NTU-UpStream/LASS-WaterBox-V2-Pro/PCB Design/LASS_WaterBox_LinkIt7697_v2.1pro/SolderpasteTop.png

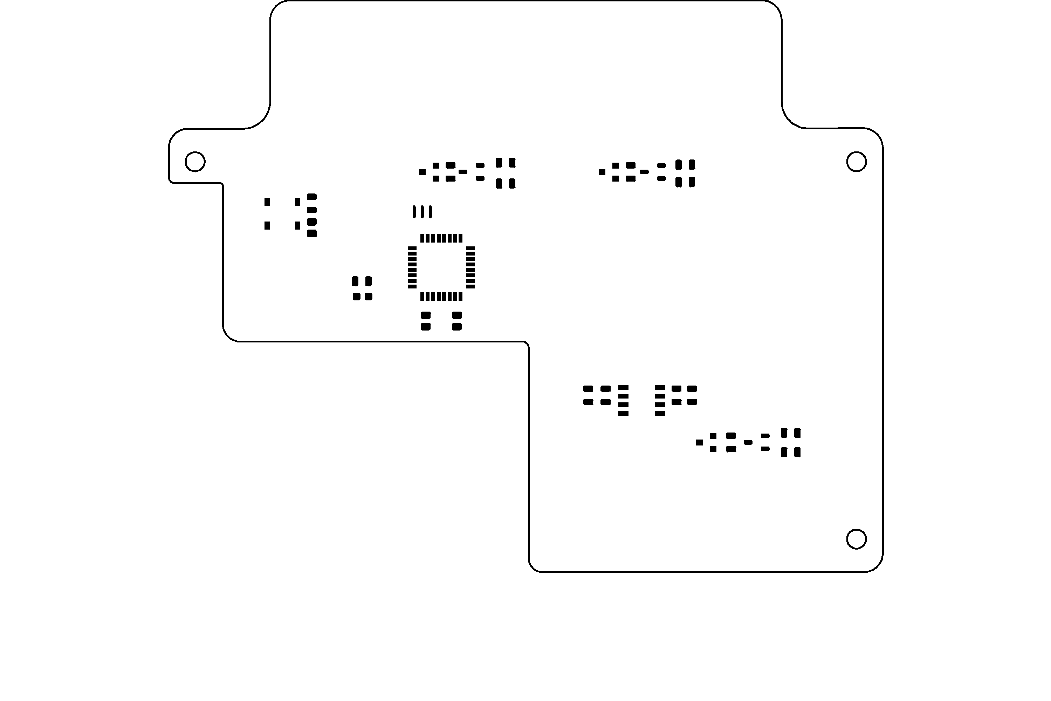
PCB Design/LASS_WaterBox_LinkIt7697_v2.1pro/SolderpasteTop.png
