NTU-UpStream/LASS-WaterBox-V2-Pro/UK NBIOT Test/修改成登入CAT-M1.png

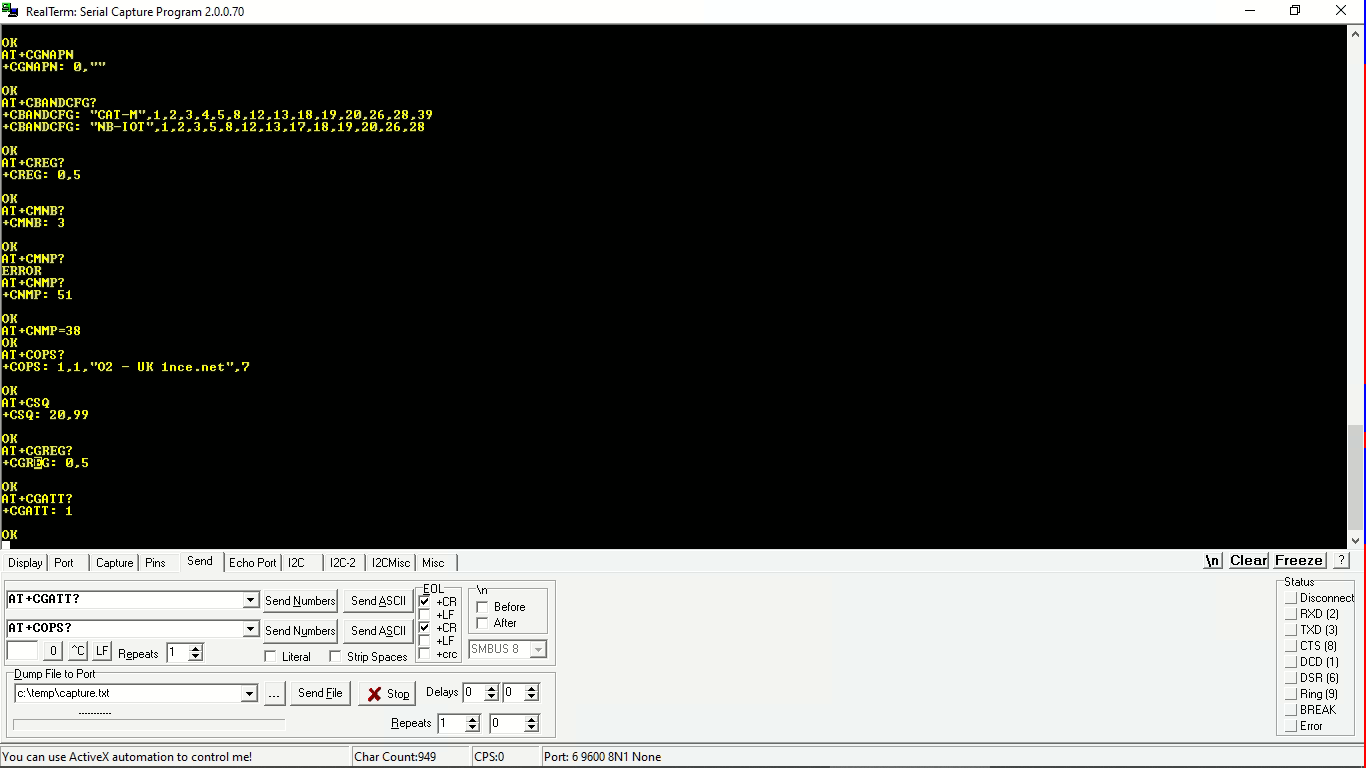
UK NBIOT Test/修改成登入CAT-M1.png
