NTU-UpStream/LASS-WaterBox-V2-Pro/UK NBIOT Test/重開機後測試設定-2.jpg

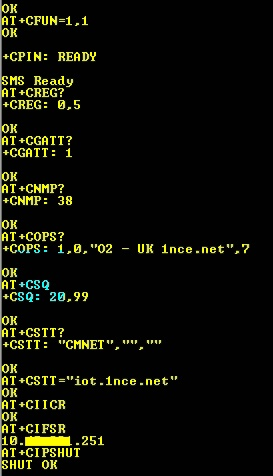
UK NBIOT Test/重開機後測試設定-2.jpg
