NTU-UpStream/LASS-WaterBox-V2-Pro/PCB Design/LASS_WaterBox_LinkIt7697_v2.1pro/base.brd

## EAGLE design PCB Design/LASS_WaterBox_LinkIt7697_v2.1pro/base.brd (2022-01-22)

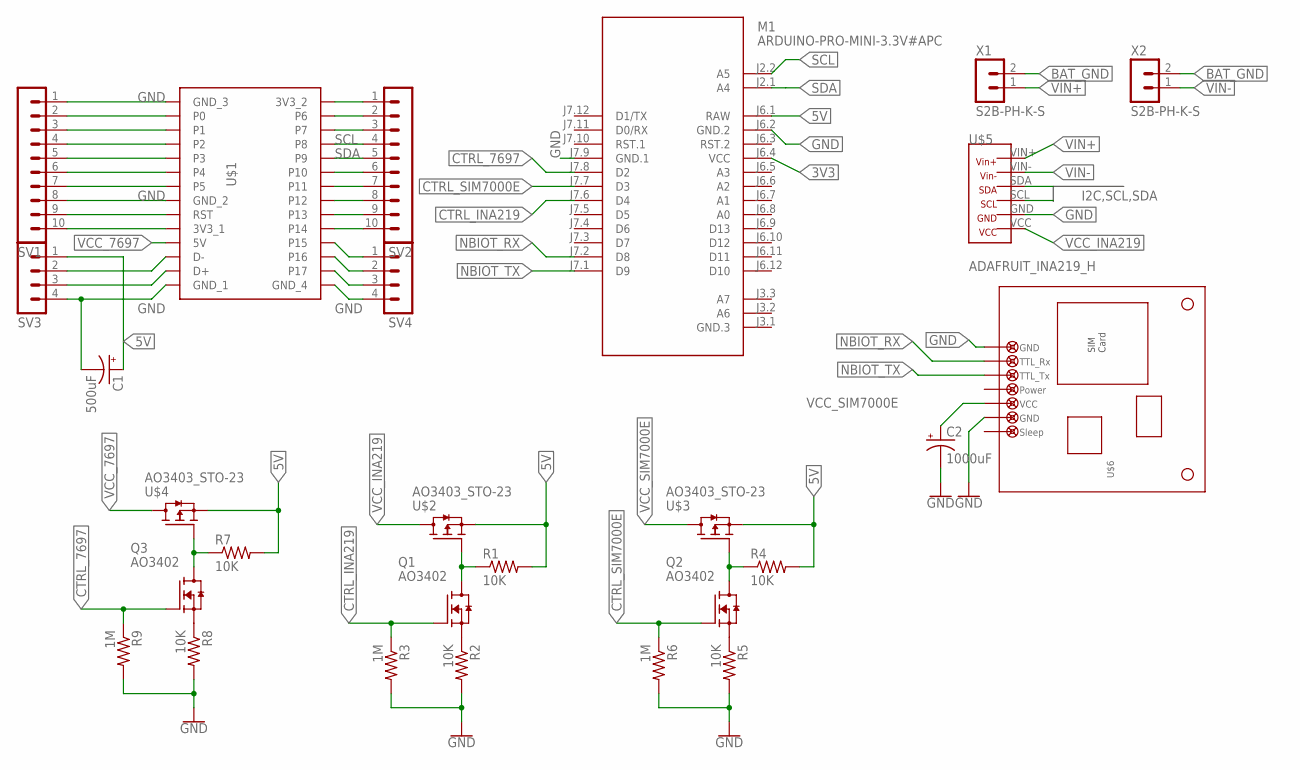
[picture p4: schematic base.sch]

Parts:
C1: 500uF; TT2D5
C2: 1000uF; TT2D5L
M1: ARDUINO-PRO-MINI-3.3V#APC; ARDUINO-PRO-MINI#APC
Q1, Q2, Q3: AO3402; SOT95P280X125-3N
R1, R2, R4, R5, R7, R8: 10K; 0207/10
R3, R6, R9: 1M; 0207/10
SV1, SV2: MA10-1
SV3, SV4: MA04-1
U$1: LINKIT_7697
U$2, U$3, U$4: AO3403_STO-23; SOT23
U$5: ADAFRUIT_INA219_H
U$6: SIM7000E; SIM7000E_AND-GLOBAL
X1, X2: S2B-PH-K-S

Connections:
3V3: M1.J6.4 (VCC)
5V: C1.+, M1.J6.1 (RAW), R1.2, R4.2, R7.2, SV3.1, U$2.2 (S), U$3.2 (S), U$4.2 (S)
BAT_GND: X1.2, X2.2
CTRL_7697: M1.J7.8 (D2), Q3.1 (G), R9.1
CTRL_INA219: M1.J7.6 (D4), Q1.1 (G), R3.1
CTRL_SIM7000E: M1.J7.7 (D3), Q2.1 (G), R6.1
GND: C1.-, C2.-, M1.J6.2 (GND.2), M1.J7.9 (GND.1), R2.2, R3.2, R5.2, R6.2, R8.2, R9.2, SV1.1, SV1.8, SV3.4, SV4.4, U$1.GND_1, U$1.GND_2, U$1.GND_3, U$1.GND_4, U$5.GND, U$6.S_GND, U$6.V_GND
unnamed: Q1.2 (S), R2.1
unnamed: Q1.3 (D), R1.1, U$2.1 (G)
unnamed: Q2.2 (S), R5.1
unnamed: Q2.3 (D), R4.1, U$3.1 (G)
unnamed: Q3.2 (S), R8.1
unnamed: Q3.3 (D), R7.1, U$4.1 (G)
unnamed: SV1.2, U$1.P0
unnamed: SV1.3, U$1.P1
unnamed: SV1.4, U$1.P2
unnamed: SV1.5, U$1.P3
unnamed: SV1.6, U$1.P4
unnamed: SV1.7, U$1.P5
unnamed: SV1.9, U$1.RST
unnamed: SV1.10, U$1.3V3_1
unnamed: SV3.2, U$1.D-
unnamed: SV3.3, U$1.D+
unnamed: SV4.3, U$1.P17
unnamed: SV4.2, U$1.P16
unnamed: SV4.1, U$1.P15
unnamed: SV2.10, U$1.P14
unnamed: SV2.9, U$1.P13
unnamed: SV2.8, U$1.P12
unnamed: SV2.7, U$1.P11
unnamed: SV2.6, U$1.P10
unnamed: SV2.3, U$1.P7
unnamed: SV2.2, U$1.P6
unnamed: SV2.1, U$1.3V3_2
NBIOT_RX: M1.J7.2 (D8), U$6.RX
NBIOT_TX: M1.J7.1 (D9), U$6.TX
SCL: M1.J2.2 (A5), SV2.4, U$1.P8, U$5.SCL
SDA: M1.J2.1 (A4), SV2.5, U$1.P9, U$5.SDA
VCC_7697: U$1.5V, U$4.3 (D)
VCC_INA219: U$2.3 (D), U$5.VCC
VCC_SIM7000E: C2.+, U$3.3 (D), U$6.VCC
VIN+: U$5.VIN+, X1.1
VIN-: U$5.VIN-, X2.1

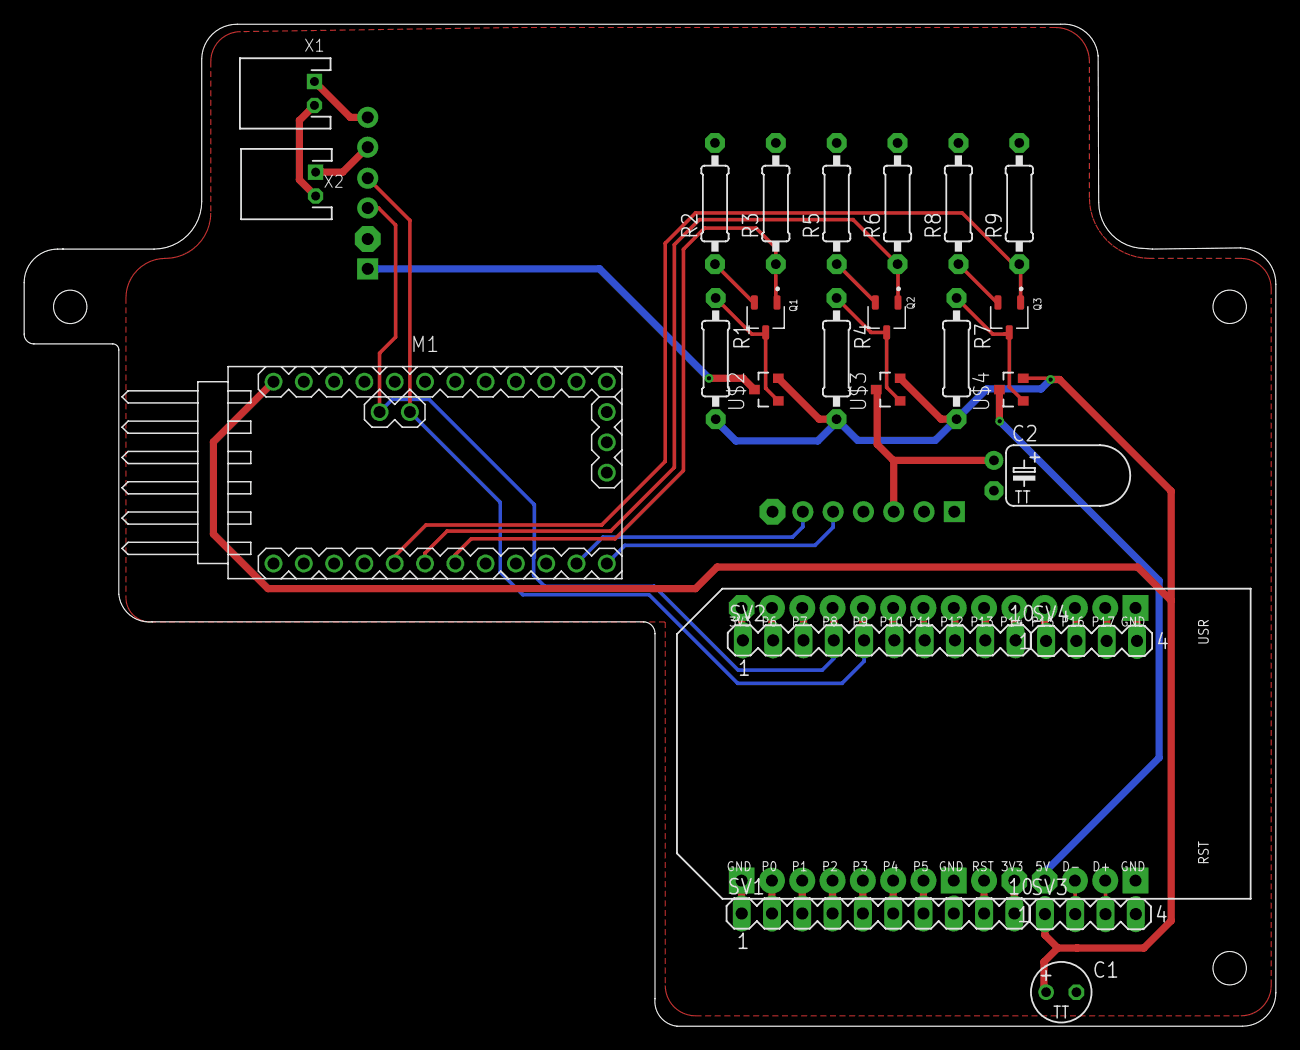
[picture p5: board base.brd from above]

Board: 2 copper layers, 104.9 x 84.0 mm, 27 parts (1 on the bottom side), 42 nets.
