NTU-UpStream/LASS-WaterBox-V2-Pro/Firmware/AllSystem_PMU_V2.1/AllSystem_PMU_V2.1.ino

/*
  Name:    WaterBox_2.ino
  Created: 2020/3/10 下午 07:28:01
  Author:  Liu
*/
#include <Adafruit_INA219.h> // 1.0.6
#include "WaterBox_PMU.h"
WaterBox_PMU PMU;

#include "SIM7000.h"
#define SIMCOM 3
SIM7000 NBIOT;


// LASS MQTT Config
#define Server_LASS "gpssensor.ddns.net"
#define Port_LASS   1883
#define MQTT_LASS_Topic "LASS/Test/WaterBox_TW/"

#define MSG_Init "|device=Linkit7697|ver_app=1.1.0|tick=0|FAKE_GPS=1"

// String _Data;
// String AT_Buffer;

// String id_str, topic_str, msg_str;
// String _buffer_str;


char STR_BUFFER[20];

char MQTT_TOPIC[35]={'\0'};  // LASS/Test/WaterBox_TW/8c882b00d4c6
char MQTT_ID[18]={'\0'};
char MQTT_MSG[300] = {'\0'};

byte MQTT_CONNECT[64] = {0};

uint32_t MQTT_PL = 0;
byte MQTT_RL[4];
uint16_t BUFFER_SIZE;
String radom_str;


/***********<< 封包格式 >>**********
  CONNECT
  PUBLISH
*********************************/
struct PUBLISH {
  uint8_t Fix_Header = 0x30 | 0b0010; // 0x30(publish) | 0b0010 (QoS:1)| 0b0001 (Retain)
  byte RL[4];
  uint8_t RL_size;

  byte PL_topic[2];
  byte TOPIC[40];

  byte PL_msg[2];
  byte MSG[300];
};

struct CONNECT {
  uint8_t Fix_Header = 0x10;
  byte RL[4];
  uint8_t RL_size;
  byte Flags = 0x02;                                     // Connect flags: 0b00000010 (Clean Session)
  byte Protocol[7] = {
    0x00, 0x04,                                          // Protocol Length: 4
    (byte)'M', (byte)'Q',  (byte)'T',  (byte)'T',        // Protocol Name:MQTT
    0x04                                                 // Protocol level (mqtt3.1.1 是0x04)
  };
  byte KeepAlive[2] = {0x00, 0x3C};                       // Keep Alive: 60 sec

  byte PL_id[2];
  byte ID[16];
};

CONNECT CONNECT_KPG;
PUBLISH PUBLISH_KPG;


/***********<< 資料整理 >>**********
  ZeroPadding
*********************************/
String ZeroPadding(byte _value) {
  if (_value < 16)  return "0" + String(_value, HEX);
  else              return String(_value, HEX);
}

void showByteBuffer(byte* _buffer, uint16_t _size) {
  for (uint16_t _i = 0; _i < _size; _i++) {
    //    Serial.print(F("0x"));
    //    Serial.print(ZeroPadding(_buffer[_i]));
    //    Serial.print(F(" "));
    Serial.print((char)_buffer[_i]);
    if (_i % 10 == 9) Serial.print(F("\r\n"));
    delay(10);
  }
  Serial.println(F("\r\n"));
}

/***********<< 封包格式 >>**********
  CalculateRL 計算RL, 填入MQTT_RL Buffer內，回傳用掉幾個bytes
*********************************/
uint8_t CalculateRL(uint32_t _size) {
  uint8_t _index = 0;
  do
  {
    uint8_t _d = _size % 128;    // 取餘數 _size & 0b01111111
    _size /= 128;                // 取除以128後的整數：_size = _size >> 7;
    if (_size > 0)  _d |= 0x80;  // 除128的整數 > 0 時，對_d + 128 (bit[7]為1)
    MQTT_RL[_index] = _d;        // 計算好的 _d 放到 buffer內
    if (_index < 3)    _index++; // 避免寫入buffer爆掉，限制_index不超過3
  } while (_size > 0);
  return _index;
}




void setup()
{
  Serial.begin(9600);

  NBIOT.begin(9600);
  NBIOT.setDebuger(Serial);
  NBIOT.init(SIMCOM);

  PMU.init();
  //  PMU.setDebuger(Serial);
  PMU.setSleepSec(2);
  PMU.setWakeUpVolate(3.2);
  PMU.PowerSaveMode(PMU.ON); // PMU.ON進入睡眠, Delay不睡覺 PMU.OFF
  PMU.setINA219(0x40);

  Serial.println(F("[System] Setup Done"));
  // 先睡一次，讓MCU 取得資料並且紀錄
  PMU.Sleep();

  radom_str = (String)"_" + (char)random(65, 90) + (char)random(65, 90) + (char)random(97, 122) + (char)random(97, 122);

}

void loop()
{
  if (PMU.state == PMU.MASTER)
  {
    //    showConfig();

    // 建立Topic
    memset(MQTT_TOPIC, '\0', 35); // 清空 Topic Buffer
    strcat(MQTT_TOPIC, MQTT_LASS_Topic);
    PMU.Field_3.toCharArray(STR_BUFFER,PMU.Field_3.length() + 1);
    strcat(MQTT_TOPIC, STR_BUFFER);

    // 建立 從Field 建立ID 的String
    id_str = PMU.Field_3 + radom_str;

    memset(MQTT_ID, '\0', 18); // 清空 ID Buffer
    strcat(MQTT_ID, STR_BUFFER);
    radom_str.toCharArray(STR_BUFFER,radom_str.length() + 1);
    strcat(MQTT_ID, STR_BUFFER);

    
    // id_str.toCharArray(CONNECT_KPG.ID, id_str.length() + 1);       // 把 ID 轉為char array

    // topic_str = MQTT_LASS_Topic + PMU.Field_3;
    // topic_str.toCharArray(PUBLISH_KPG.TOPIC, topic_str.length() + 1); // 把 TOPIC 轉為char array
    // PUBLISH_KPG.PL_topic[0] = topic_str.length() / 256;
    // PUBLISH_KPG.PL_topic[1] = topic_str.length() % 256;

    // 把要傳送封包(LASS 格式), 打包成String
    // msg_str = "|device=Linkit7697|device_id=9C65F920C020|ver_app=1.1.0|date=2019-03-21|time=06:53:55|tick=0|FAKE_GPS=1|gps_lon=121.787|gps_lat=25.1933|s_ec=200000.00|s_ph=14.00|s_t0=100.00|s_Tb=10000.00|bat_v=3.70|bat_a=400.00|";
    msg_str = "|device=Linkit7697|ver_app=1.1.0|tick=0|FAKE_GPS=1";
    msg_str.concat(F("|date="));      msg_str.concat(PMU.Field_1);
    msg_str.concat(F("|time="));      msg_str.concat(PMU.Field_2);
    msg_str.concat(F("|device_id=")); msg_str.concat(PMU.Field_3);
    msg_str.concat(F("|gps_lon="));   msg_str.concat(PMU.Field_4);
    msg_str.concat(F("|gps_lat="));   msg_str.concat(PMU.Field_5);
    msg_str.concat(F("|s_ec="));      msg_str.concat(PMU.Field_6);
    msg_str.concat(F("|s_ph="));      msg_str.concat(PMU.Field_7);
    msg_str.concat(F("|s_t0="));      msg_str.concat(PMU.Field_8);
    msg_str.concat(F("|s_Tb="));      msg_str.concat(PMU.Field_9);
    msg_str.concat(F("|bat_v="));     msg_str.concat(PMU.Field_10);
    msg_str.concat(F("|bat_a="));     msg_str.concat(PMU.Field_11);
    msg_str.concat(F("|"));

    Serial.println("[Device ID-1]");
    Serial.println(MQTT_ID);

    Serial.println("[TOPIC-2]");
    Serial.println(MQTT_TOPIC);

    Serial.println("[MQTT MSG]");    
    Serial.println(msg_str);


    CONNECT_KPG.PL_id[0] = msg_str.length() / 256;
    CONNECT_KPG.PL_id[1] = msg_str.length() % 256;

    MQTT_PL = 2 + id_str.length();                      // 計算RL長度 = 2+PL(Topic)+2+PL(Payload)
    CONNECT_KPG.RL_size =  CalculateRL(MQTT_PL);        // 計算RL 用掉幾個bytes，並更新MQTT_RL 這個Buffer
    memcpy(CONNECT_KPG.RL, MQTT_RL, 4);                 // 把MQTT_RL 這個Buffer 複製到PUBLIC_KPG裡面

    // 把LASS封包(String) 塞到Char Buffer當中
    msg_str.toCharArray(PUBLISH_KPG.MSG, msg_str.length() + 1);       // 把 MSG 轉為char array
    PUBLISH_KPG.PL_msg[0] = msg_str.length() / 256;
    PUBLISH_KPG.PL_msg[1] = msg_str.length() % 256;

    MQTT_PL = 2 + topic_str.length() + 2 + msg_str.length();  // 計算RL長度 = 2+PL(Topic)+2+PL(Payload)
    PUBLISH_KPG.RL_size =  CalculateRL(MQTT_PL);              // 計算RL 用掉幾個bytes，並更新MQTT_RL 這個Buffer
    memcpy(PUBLISH_KPG.RL, MQTT_RL, 4);                       // 把MQTT_RL 這個Buffver 複製到PUBLIC_KPG裡面

    // 把TOPIC內容show 出來，確認內容是否ＯＫ
    showByteBuffer(PUBLISH_KPG.TOPIC, topic_str.length() + 6);

  /*  
    // 把MSG內容show 出來，確認內容是否ＯＫ
    showByteBuffer(PUBLISH_KPG.MSG, msg_str.length() + 1);

    NBIOT.AT_CMD(F("AT+CIPSENDHEX=1"), true);               // 設定 TCP/IP的傳輸格式為HEX
    delay(500);
    AT_Buffer = (String)"AT+CSTT=\"" + PMU.APN + "\"";
    NBIOT.AT_CMD(AT_Buffer, true);                         // 設定 APN
    delay(1500);
    NBIOT.AT_CMD(F("AT+CIICR"), true);                     // 啟動網路功能
    delay(1500);

    NBIOT.AT_CMD(F("AT+CIFSR"), true);                     // 取得IP
    delay(1500);

    AT_Buffer = (String)"AT+CIPSTART=\"TCP\",\"" + Server_LASS + "\",\"" + String(Port_LASS) + "\"";
    NBIOT.AT_CMD(AT_Buffer, true);                         // 啟動 TCP 連線
    delay(2000);
    
    NBIOT.AT_end();
    NBIOT.closeNetwork();

    */

    PMU.Sleep();
  }
}
