NTU-UpStream/LASS-WaterBox-V2-Pro/Firmware/TestCode_MCU_OLED_u8g2Logo/TestCode_MCU_OLED_u8g2Logo.ino

#include <Arduino.h>
#include <U8g2lib.h>

#ifdef U8X8_HAVE_HW_SPI
#include <SPI.h>
#endif
#ifdef U8X8_HAVE_HW_I2C
#include <Wire.h>
#endif

/*
  U8glib Example Overview:
    Frame Buffer Examples: clearBuffer/sendBuffer. Fast, but may not work with all Arduino boards because of RAM consumption
    Page Buffer Examples: firstPage/nextPage. Less RAM usage, should work with all Arduino boards.
    U8x8 Text Only Example: No RAM usage, direct communication with display controller. No graphics, 8x8 Text only.

  This is a page buffer example.
*/

// Please UNCOMMENT one of the contructor lines below
// U8g2 Contructor List (Picture Loop Page Buffer)
// The complete list is available here: https://github.com/olikraus/u8g2/wiki/u8g2setupcpp
// Please update the pin numbers according to your setup. Use U8X8_PIN_NONE if the reset pin is not connected
//U8G2_SSD1306_128X64_NONAME_1_HW_I2C u8g2(U8G2_R0, /* reset=*/ U8X8_PIN_NONE);
//U8G2_SSD1306_128X64_NONAME_1_SW_I2C u8g2(U8G2_R0, /* clock=*/ 13, /* data=*/ 11, /* reset=*/ 8);
//U8G2_SSD1306_128X64_NONAME_1_SW_I2C u8g2(U8G2_R0, /* clock=*/ SCL, /* data=*/ SDA, /* reset=*/ U8X8_PIN_NONE);   // All Boards without Reset of the Display
//U8G2_SH1106_128X64_NONAME_1_HW_I2C u8g2(U8G2_R0, /* reset=*/ U8X8_PIN_NONE);
U8G2_SSD1306_128X64_NONAME_1_4W_HW_SPI u8g2(U8G2_R0, /* cs=*/ 15, /* dc=*/ 16, /* reset=*/ 17);

// End of constructor list

#define ModulePower 14

//#define MINI_LOGO

void setup(void) {
  /* U8g2 Project: SSD1306 Test Board */
  pinMode(ModulePower, OUTPUT);
  digitalWrite(ModulePower, HIGH);

  u8g2.begin();
  u8g2.setFlipMode(0);
}

void drawLogo(void)
{
  uint8_t mdy = 0;
  if ( u8g2.getDisplayHeight() < 59 )
    mdy = 5;


  u8g2.setFontMode(1);	// Transparent
  u8g2.setDrawColor(1);
#ifdef MINI_LOGO

  u8g2.setFontDirection(0);
  u8g2.setFont(u8g2_font_inb16_mf);
  u8g2.drawStr(0, 22, "U");

  u8g2.setFontDirection(1);
  u8g2.setFont(u8g2_font_inb19_mn);
  u8g2.drawStr(14, 8, "8");

  u8g2.setFontDirection(0);
  u8g2.setFont(u8g2_font_inb16_mf);
  u8g2.drawStr(36, 22, "g");
  u8g2.drawStr(48, 22, "\xb2");

  u8g2.drawHLine(2, 25, 34);
  u8g2.drawHLine(3, 26, 34);
  u8g2.drawVLine(32, 22, 12);
  u8g2.drawVLine(33, 23, 12);
#else

  u8g2.setFontDirection(0);
  u8g2.setFont(u8g2_font_inb24_mf);
  u8g2.drawStr(0, 30 - mdy, "U");

  u8g2.setFontDirection(1);
  u8g2.setFont(u8g2_font_inb30_mn);
  u8g2.drawStr(21, 8 - mdy, "8");

  u8g2.setFontDirection(0);
  u8g2.setFont(u8g2_font_inb24_mf);
  u8g2.drawStr(51, 30 - mdy, "g");
  u8g2.drawStr(67, 30 - mdy, "\xb2");

  u8g2.drawHLine(2, 35 - mdy, 47);
  u8g2.drawHLine(3, 36 - mdy, 47);
  u8g2.drawVLine(45, 32 - mdy, 12);
  u8g2.drawVLine(46, 33 - mdy, 12);

#endif
}

void drawURL(void)
{
#ifndef MINI_LOGO
  u8g2.setFont(u8g2_font_4x6_tr);
  if ( u8g2.getDisplayHeight() < 59 )
  {
    u8g2.drawStr(89, 20 - 5, "github.com");
    u8g2.drawStr(73, 29 - 5, "/olikraus/u8g2");
  }
  else
  {
    u8g2.drawStr(1, 54, "github.com/olikraus/u8g2");
  }
#endif
}

void drawCOUNTER(String _c)
{
  uint8_t mdy = 0;
  if ( u8g2.getDisplayHeight() < 59 )
    mdy = 5;

  u8g2.setFontMode(1); // Transparent
  u8g2.setDrawColor(1);
#ifdef MINI_LOGO
  u8g2.setFontDirection(0);
  u8g2.setFont(u8g2_font_inb16_mf);
  u8g2.drawStr(0, 22, "U");

  u8g2.setFontDirection(1);
  u8g2.setFont(u8g2_font_inb19_mn);
  u8g2.drawStr(14, 8, "8");

  u8g2.setFontDirection(0);
  u8g2.setFont(u8g2_font_inb16_mf);
  u8g2.drawStr(36, 22, "g");
  u8g2.drawStr(48, 22, "\xb2");
  u8g2.drawStr(56, 22, _c);

  u8g2.drawHLine(2, 25, 34);
  u8g2.drawHLine(3, 26, 34);
  u8g2.drawVLine(32, 22, 12);
  u8g2.drawVLine(33, 23, 12);
#else

  u8g2.setFontDirection(0);
  u8g2.setFont(u8g2_font_inb24_mf);
  u8g2.drawStr(0, 30 - mdy, "U");

  u8g2.setFontDirection(1);
  u8g2.setFont(u8g2_font_inb30_mn);
  u8g2.drawStr(21, 8 - mdy, "8");

  u8g2.setFontDirection(0);
  u8g2.setFont(u8g2_font_inb24_mf);
  u8g2.drawStr(51, 30 - mdy, "g");
  u8g2.drawStr(67, 30 - mdy, "\xb2");

  u8g2.drawHLine(2, 35 - mdy, 47);
  u8g2.drawHLine(3, 36 - mdy, 47);
  u8g2.drawVLine(45, 32 - mdy, 12);
  u8g2.drawVLine(46, 33 - mdy, 12);
#endif

}

uint16_t _counter = 0;
String _str_counter;

void loop(void) {
  _counter++;
  _str_counter=String(_counter);
  

  u8g2.firstPage();

  do {
    drawLogo();
    drawURL();
    drawCOUNTER(_str_counter);
  } while ( u8g2.nextPage() );
  delay(4000);
}
