NTU-UpStream/LASS-WaterBox-V2-Pro/(commit log)

2022-01-22 Ver 1.1
    add pcb file
    [Ver2.brd, Ver2.sch, base.brd, base.sch]
2022-01-22 Ver 1.1
    modify LED function
2022-02-16 modify ArduinoLibrary
2022-05-08 fixed MenuSystem.cpp error
    function: int MenuSystem::SPI_select(SPI_device device)
    add return 0;
    [AllSystem_PMU_V2.1.ino]
2022-05-09 fixed AllSystem_PMU_V2.1.b.ino connect package formate
    [AllSystem_PMU_V2.1.b.ino, TestCode_MCU_MQTTPublish.ino]
2022-05-20 fix INA219 Power On timing bug
    [AllSystem_MCU_V2.1.ino, AllSystem_PMU_V2.1.b.ino, TestCode_MCU_Menu.ino, WaterBox_PMU.cpp]
2022-06-03 modify Turbidity ADC formula
2022-06-29 fixed auto add Field data
    [AllSystem_PMU_V2.1.b.ino]
2022-10-24 Ver 1.0
    add Power control pin
    add MQTT init function
    add MQTT publish function
2023-03-25 fixed TestCode_MCU I2C clock setting
    [TestCode_MCU_Atlas.ino]
2023-04-12 [BUG Fixed] NBIOT Power OFF
    [AllSystem_PMU_V2.3_ublox.ino]
2023-04-13 fixed (uint8_t->uint_16_t) _PowerSave memory overflow
    [WaterBox_PMU.cpp, WaterBox_PMU.h]
2023-04-13 Fixed _SleepSec overwrite by _PowerSave
    [AllSystem_PMU_V2.3_ublox.ino, WaterBox_PMU.cpp, WaterBox_PMU.h]
